adafruit/Adafruit-VEML7700-PCB/Adafruit VEML7700 STEMMA QT.brd

## EAGLE design Adafruit VEML7700 STEMMA QT.brd (2022-02-11)

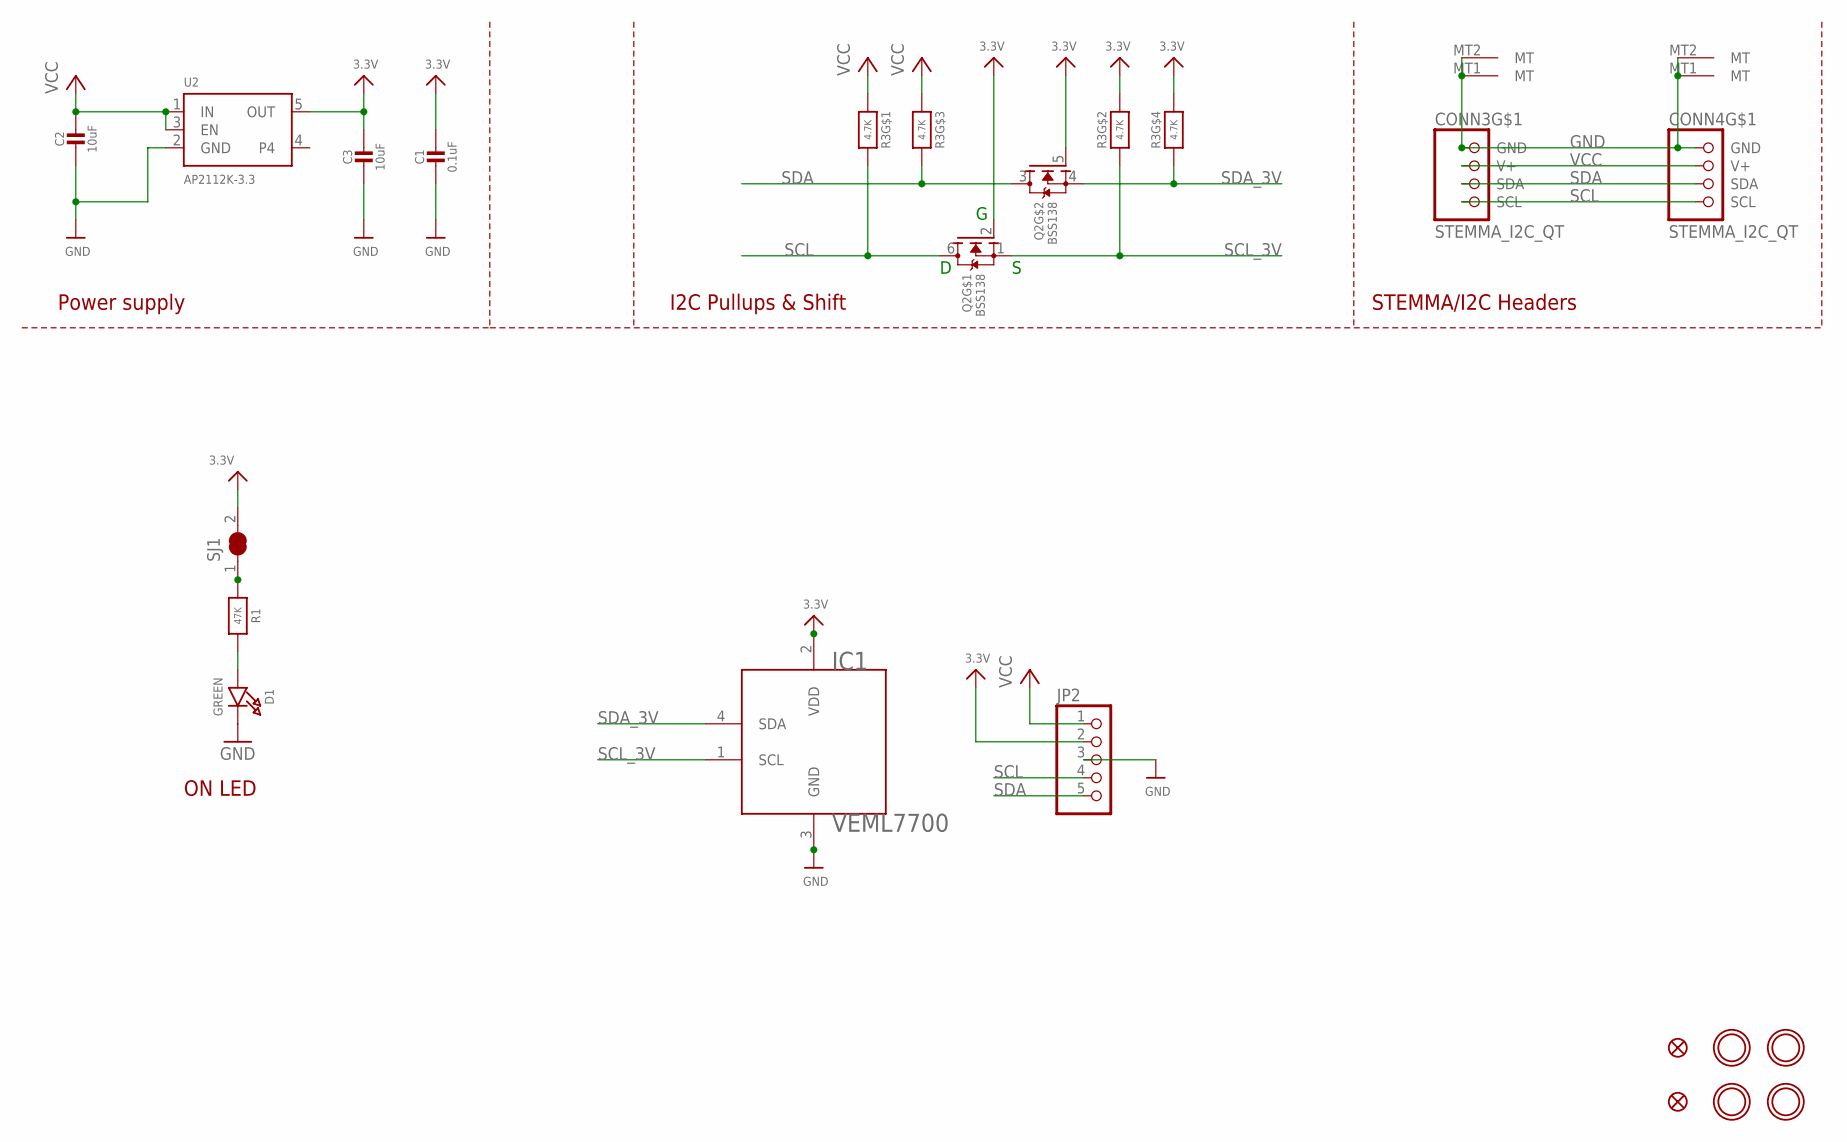
[picture p3: schematic Adafruit VEML7700 STEMMA QT.sch]

Parts:
C1: 0.1uF; 0603-NO
C2, C3: 10uF; 0805-NO
CONN3, CONN4: STEMMA_I2C_QT; JST_SH4
D1: GREEN; CHIPLED_0603_NOOUTLINE
FID3, FID4: FIDUCIAL_1MM
IC1: VEML7700
JP2: HEADER-1X5ROUND; 1X05_ROUND
Q2: BSS138; SOT363
R1: 47K; 0603-NO
R3: 4.7K; RESPACK_4X0603
SJ1: SOLDERJUMPER_CLOSED; SOLDERJUMPER_CLOSEDWIRE
U2: AP2112K-3.3; SOT23-5
U$1, U$17, U$19, U$21: MOUNTINGHOLE2.5; MOUNTINGHOLE_2.5_PLATED

Connections:
3.3V: C1.1, C3.1, IC1.2 (VDD), JP2.2, Q2.2 (G), Q2.5 (G), R3.2 (1), R3.4 (1), SJ1.2, U2.5 (OUT)
GND: C1.2, C2.2, C3.2, CONN3.1 (GND), CONN3.MT1 (MT), CONN3.MT2 (MT), CONN4.1 (GND), CONN4.MT1 (MT), CONN4.MT2 (MT), D1.C, IC1.3 (GND), JP2.3, U2.2 (GND)
unnamed: D1.A, R1.2
unnamed: R1.1, SJ1.1
SCL: CONN3.4 (SCL), CONN4.4 (SCL), JP2.4, Q2.6 (D), R3.8 (2)
SCL_3V: IC1.1 (SCL), Q2.1 (S), R3.7 (2)
SDA: CONN3.3 (SDA), CONN4.3 (SDA), JP2.5, Q2.3 (D), R3.6 (2)
SDA_3V: IC1.4 (SDA), Q2.4 (S), R3.5 (2)
VCC: C2.1, CONN3.2 (V+), CONN4.2 (V+), JP2.1, R3.1, R3.3 (1), U2.1 (IN), U2.3 (EN)

Notes on the sheet:
I2C Pullups & Shift
STEMMA/I2C Headers
ON LED
Power supply

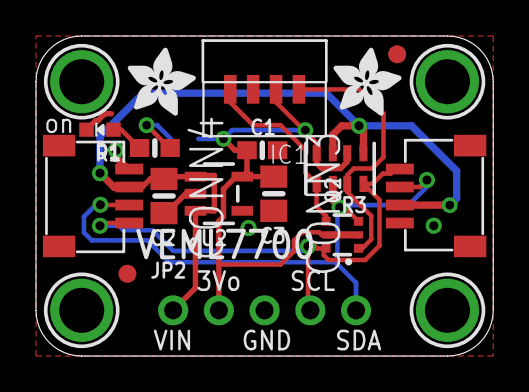
[picture p4: board Adafruit VEML7700 STEMMA QT.brd from above]

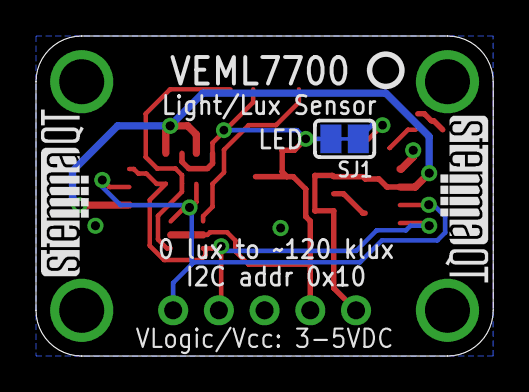
[picture p5: board Adafruit VEML7700 STEMMA QT.brd from below]

Board: 2 copper layers, 25.4 x 17.8 mm, 25 parts (5 on the bottom side), 9 nets.

Other parts of the board:
U$2: KATTNI_STOP
U$4, U$22: ADAFRUIT_3.5MM
U$25: PCBFEAT-REV-040
U$30, U$31: STEMMAQT
