adafruit/Adafruit-VEML7700-PCB/Adafruit VEML7700.brd

## EAGLE design Adafruit VEML7700.brd (2019-03-28)

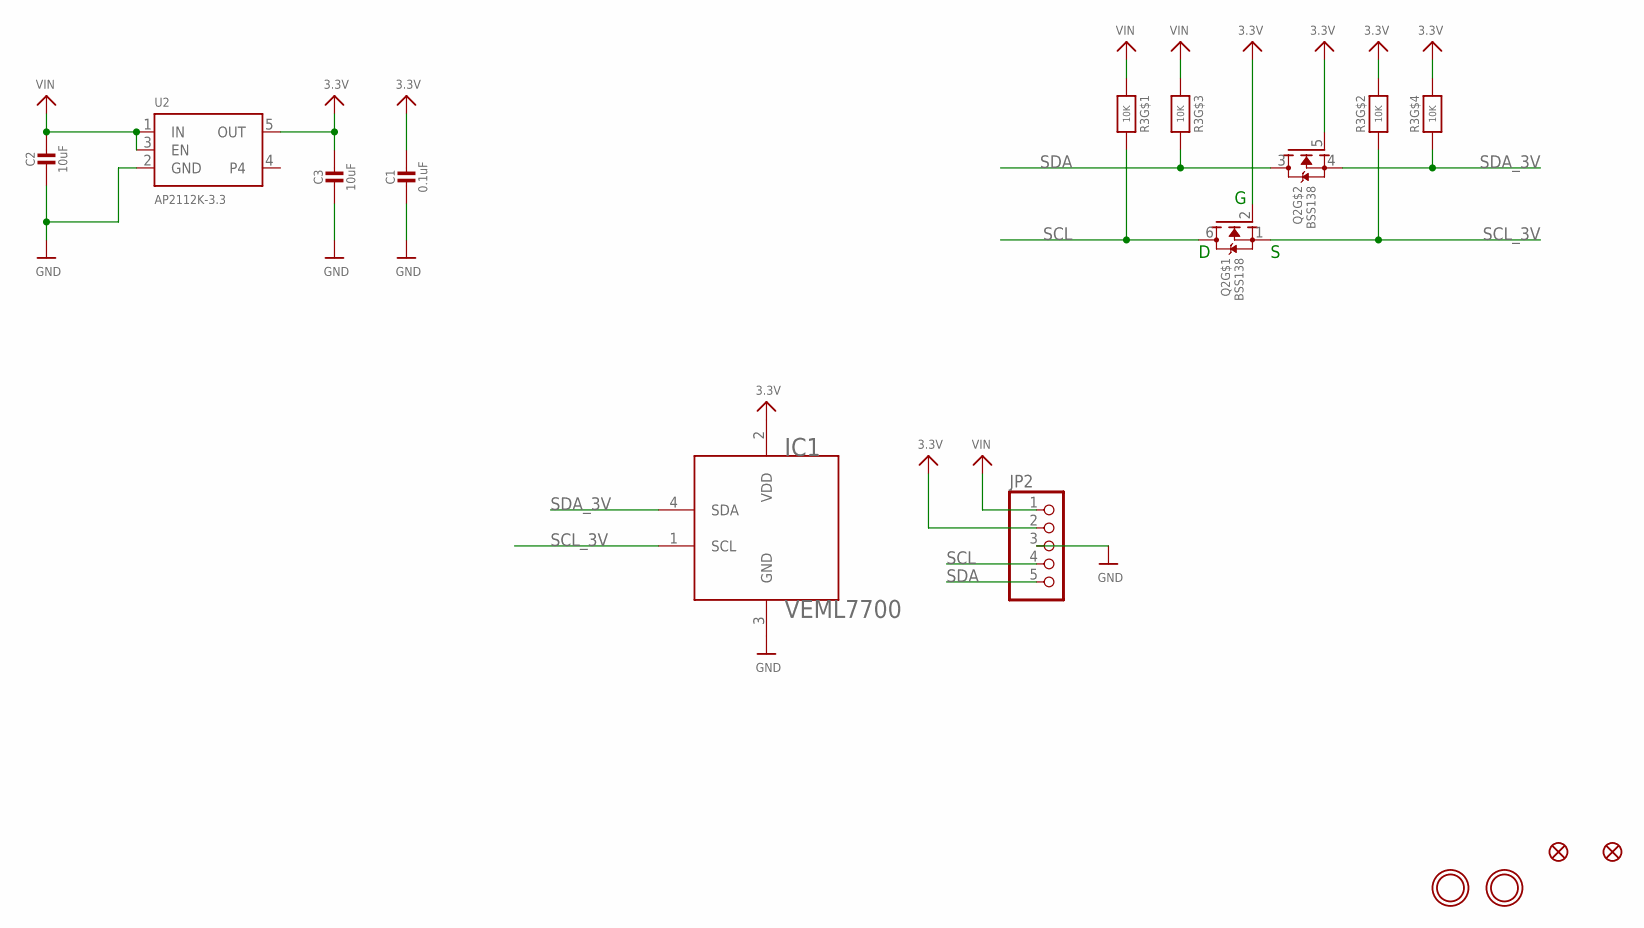
[picture p6: schematic Adafruit VEML7700.sch]

Parts:
C1: 0.1uF; 0603-NO
C2, C3: 10uF; 0805-NO
FID1, FID2: FIDUCIAL_1MM
IC1: VEML7700
JP2: HEADER-1X5ROUND; 1X05_ROUND
Q2: BSS138; SOT363
R3: 10K; RESPACK_4X0603
U2: AP2112K-3.3; SOT23-5
U$3, U$4: MOUNTINGHOLE2.5; MOUNTINGHOLE_2.5_PLATED

Connections:
3.3V: C1.1, C3.1, IC1.2 (VDD), JP2.2, Q2.2 (G), Q2.5 (G), R3.2 (1), R3.4 (1), U2.5 (OUT)
GND: C1.2, C2.2, C3.2, IC1.3 (GND), JP2.3, U2.2 (GND)
SCL: JP2.4, Q2.6 (D), R3.8 (2)
SCL_3V: IC1.1 (SCL), Q2.1 (S), R3.7 (2)
SDA: JP2.5, Q2.3 (D), R3.6 (2)
SDA_3V: IC1.4 (SDA), Q2.4 (S), R3.5 (2)
VIN: C2.1, JP2.1, R3.1, R3.3 (1), U2.1 (IN), U2.3 (EN)

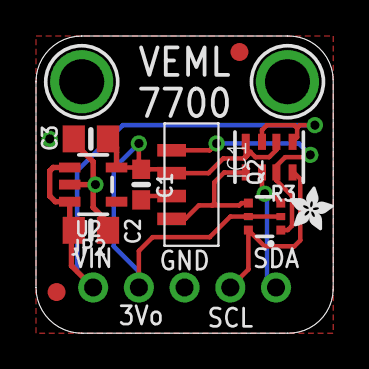
[picture p7: board Adafruit VEML7700.brd from above]

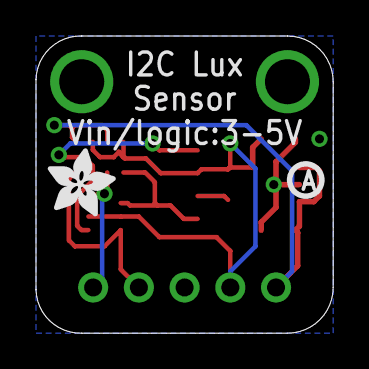
[picture p8: board Adafruit VEML7700.brd from below]

Board: 2 copper layers, 16.5 x 16.5 mm, 16 parts (3 on the bottom side), 7 nets.

Other parts of the board:
U$1: ADAFRUIT_3.5MM
U$8: ADAFRUIT_2.5MM
U$12: KATTNI_STOP
U$27: PCBFEAT-REV-040
