adafruit/Adafruit-VEML7700-PCB/(commit log)

2019-03-28 Adding brd/sch files
    [Adafruit VEML7700.brd, Adafruit VEML7700.sch]
2019-07-17 updated to use cookiecutter for pcb repos
2022-02-11 Add STEMMA QT board files.
    [Adafruit VEML7700 STEMMA QT.brd, Adafruit VEML7700 STEMMA QT.sch]
